natephan/EzPlant/diagrams/masterController.jpg

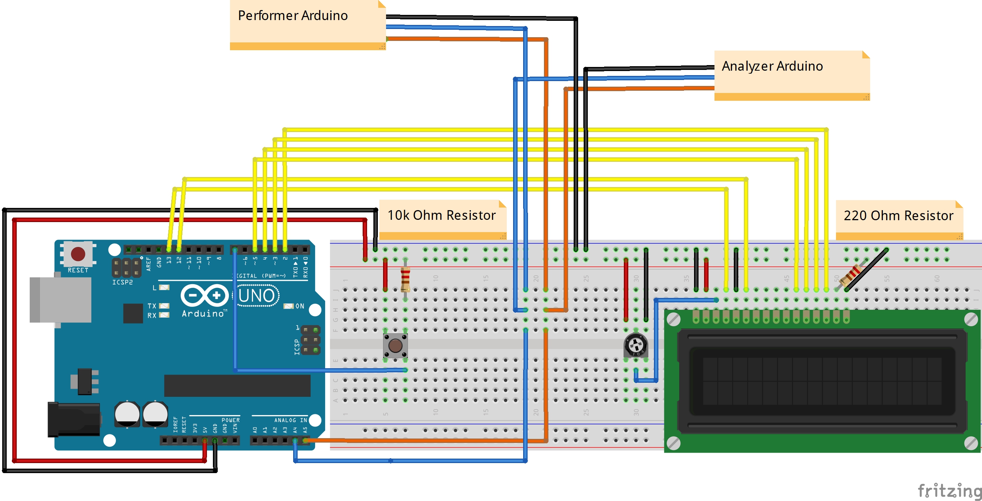
diagrams/masterController.jpg
