natephan/EzPlant/(list of files, drawings)

Other design files:
diagrams/fritzing/allTogether.fzz
diagrams/fritzing/analyzer.fzz
diagrams/fritzing/masterController.fzz
diagrams/fritzing/outlet.fzz
diagrams/fritzing/performer.fzz
